Liverpool-AlertLab/loopo_manufacturing/actuator/STL/actuator-mainbody.stl

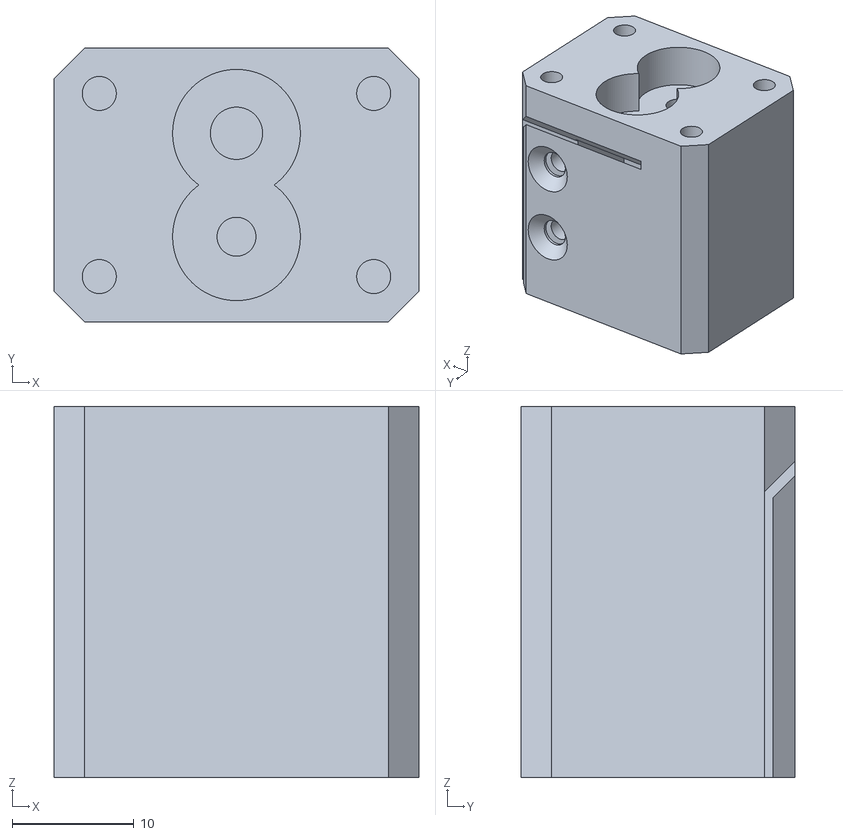
[picture p24: CAD file, 2023-09-11]
actuator/STL/actuator-mainbody.stl
30.0 x 22.5 x 30.5
