Liverpool-AlertLab/loopo_manufacturing/plain-finger/STL/plainfinger-mainbody.stl

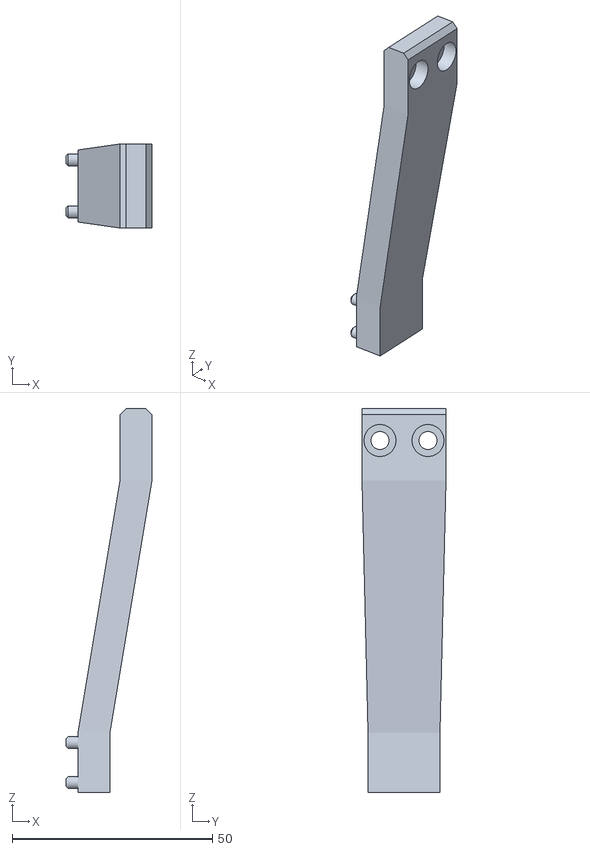
[picture p25: CAD file, 2023-09-11]
plain-finger/STL/plainfinger-mainbody.stl
21.5 x 21.0 x 96.0
