Liverpool-AlertLab/loopo_manufacturing/CLG-finger/STL/CLGfinger-mainbody.stl

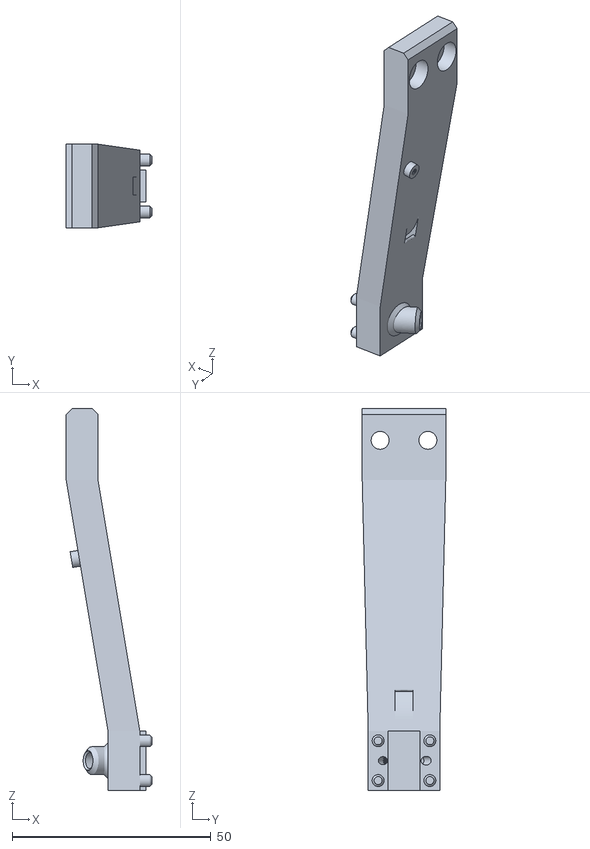
[picture p26: CAD file, 2023-09-11]
CLG-finger/STL/CLGfinger-mainbody.stl
21.5 x 21.0 x 96.0
