Liverpool-AlertLab/loopo_manufacturing/actuator/STL/shaft adapter.stl

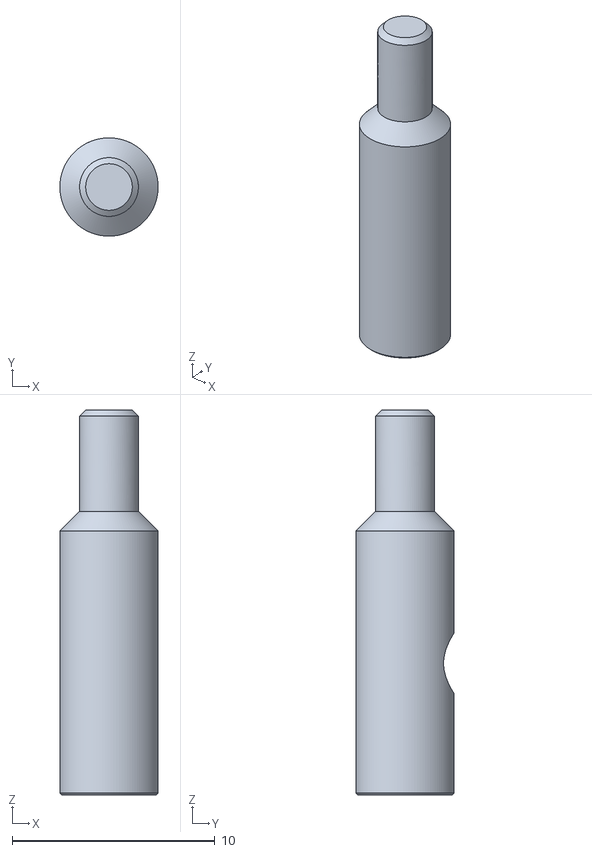
[picture p27: CAD file, 2023-09-11]
actuator/STL/shaft adapter.stl
4.85 x 4.85 x 19.0
