Liverpool-AlertLab/loopo_manufacturing/CLG-finger/CLG-finger.step

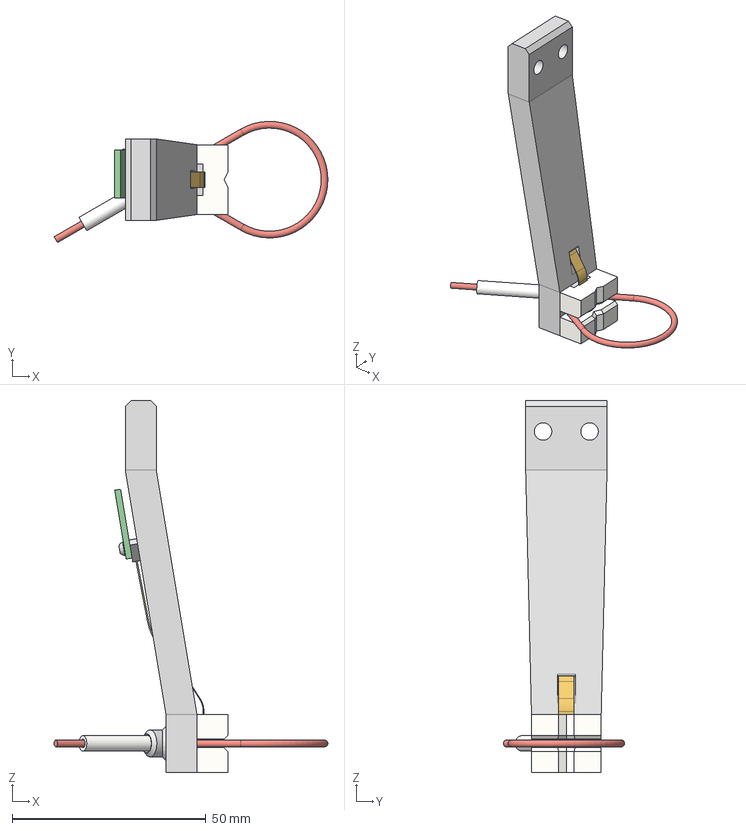
[picture p28: CAD file, 2023-09-11]
CLG-finger/CLG-finger.step
70.7 x 31.3 x 96.0 mm
Finger
Fingertip top
Fingertip bottom
Cable rest
Capacitance Sensor v2
Singletact PDMS
Button Head Hex Drive Screw
Alloy Steel Cone-Point Set Screw
Cable
Bowden tube
