Liverpool-AlertLab/loopo_manufacturing/CLG-finger/STL/CLGfinger-topfingertip.stl

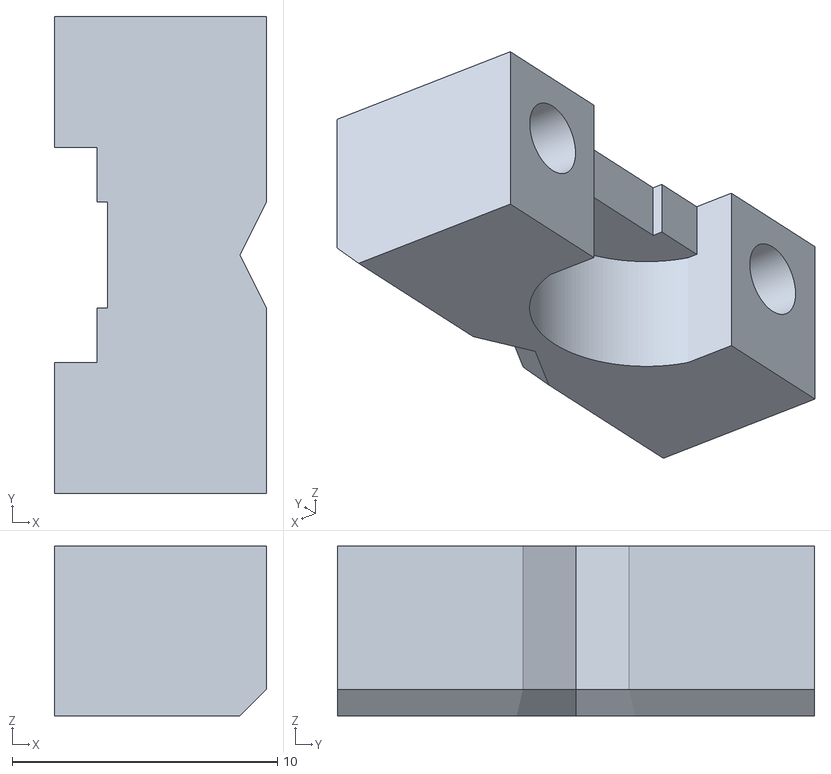
[picture p29: CAD file, 2023-09-11]
CLG-finger/STL/CLGfinger-topfingertip.stl
8.00 x 18.0 x 6.40
