Liverpool-AlertLab/loopo_manufacturing/plain-finger/plain-finger.step

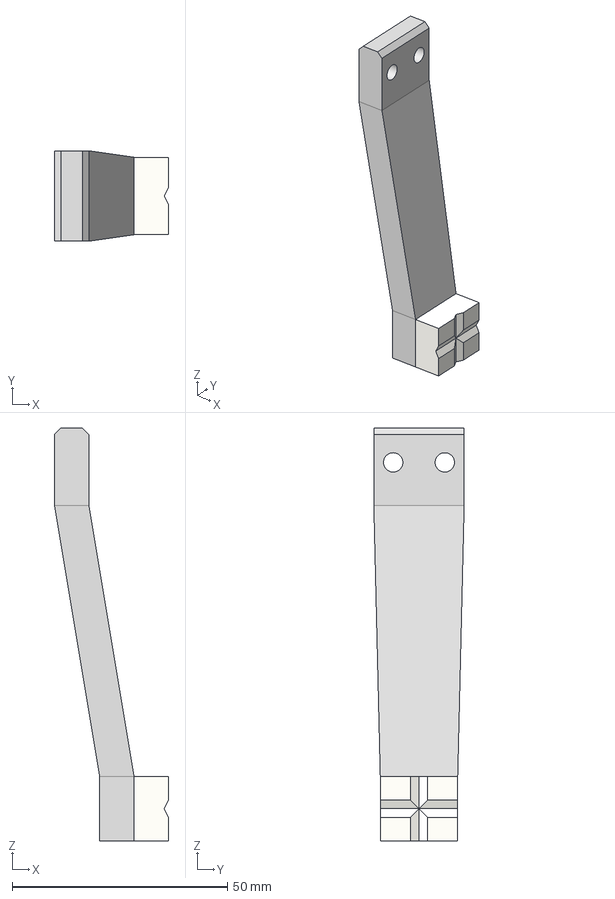
[picture p30: CAD file, 2023-09-11]
plain-finger/plain-finger.step
26.5 x 21.0 x 96.0 mm
Finger
Tip
