Liverpool-AlertLab/loopo_manufacturing/plain-finger/STL/plainfinger-fingertip.stl

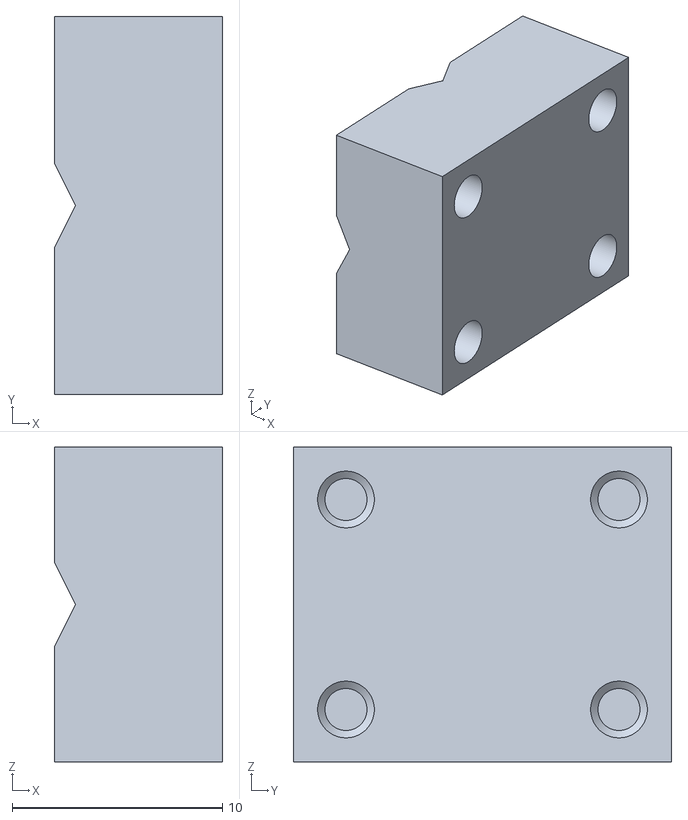
[picture p31: CAD file, 2023-09-11]
plain-finger/STL/plainfinger-fingertip.stl
8.00 x 18.0 x 15.0
