Liverpool-AlertLab/loopo_manufacturing/actuator/STL/actuator-gearcover.stl

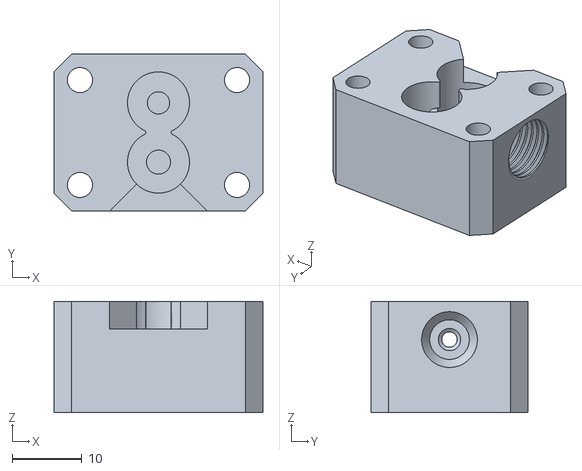
[picture p32: CAD file, 2023-09-11]
actuator/STL/actuator-gearcover.stl
30.0 x 22.5 x 16.0
