Liverpool-AlertLab/loopo_manufacturing/actuator/STL/actuator-encodercover.stl

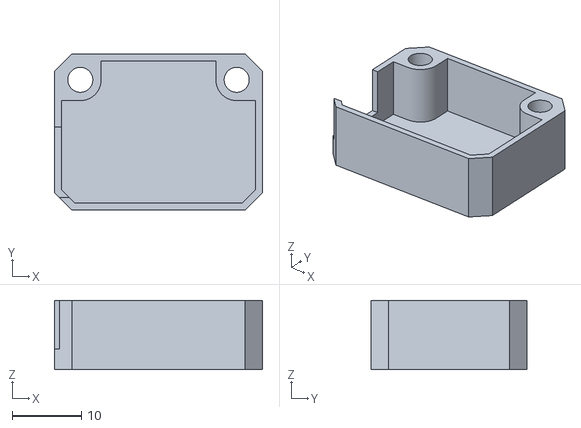
[picture p33: CAD file, 2023-09-11]
actuator/STL/actuator-encodercover.stl
30.0 x 22.5 x 10.0
