Liverpool-AlertLab/loopo_manufacturing/actuator/STL/actuator.3mf

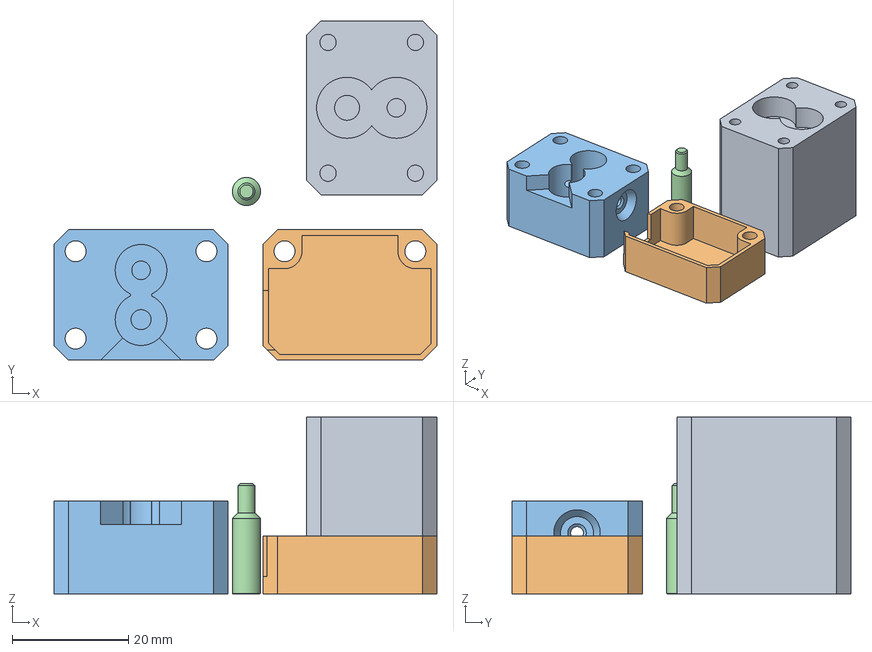
[picture p34: CAD file, 2023-09-11]
actuator/STL/actuator.3mf
66.0 x 58.5 x 30.5 mm
actuator-mainbody.stl
actuator-encodercover.stl
actuator-gearcover.stl
shaft adapter.stl
