Liverpool-AlertLab/loopo_manufacturing/(list of files, cad)

Other CAD files:
CLG-finger/STL/CLGfinger-bottomfingertip.stl
CLG-finger/CLG-finger.f3d
actuator/actuator.f3d
plain-finger/plain-finger.f3d
