Liverpool-AlertLab/loopo_manufacturing/(commit log)

2023-08-28 Added F360 files for both fingers
    [CLG Finger.f3d, CLG Twist Finger.f3d]
2023-08-28 added STEP files for both fingers
    [CLG Finger.step, CLG Twist Finger.step]
2023-09-11 Added plain finger files and documentation
    [plain-finger.f3d, plain-finger.step, plainfinger-fingertip.stl, plainfinger-mainbody.stl]
2023-09-11 Added documentation for the CLG finger device
    [CLG-finger.f3d, CLG-finger.step, CLGfinger-bottomfingertip.stl, CLGfinger-mainbody.stl, CLGfinger-topfingertip.stl]
2023-09-11 Added documentation and files for actuator device
    [actuator-encodercover.stl, actuator-gearcover.stl, actuator-mainbody.stl, actuator.3mf, actuator.f3d, shaft adapter.stl]
2023-09-11 general cleanup
    [CLG Finger.f3d, CLG Finger.step, CLG Twist Finger.f3d, CLG Twist Finger.step]
